OlegBEZb/Altium_CP/Altium_CP/Трёхмерный.png

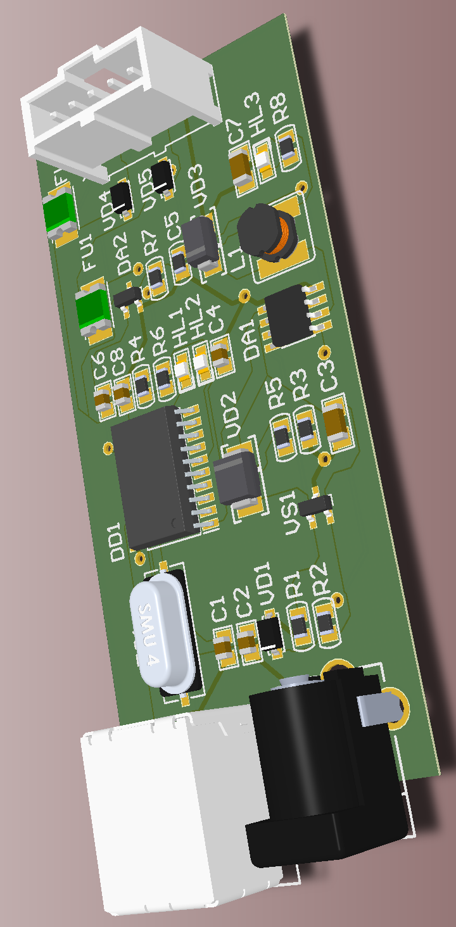
Altium_CP/Трёхмерный.png
