OlegBEZb/Altium_CP/README.md

Предмет: Программирование микроконтроллеров в робототехнике  
Преподаватель: Капустин Дмитрий Николаевич  
Семестр: 7
