OlegBEZb/Altium_CP/Altium_CP/Боттом.png

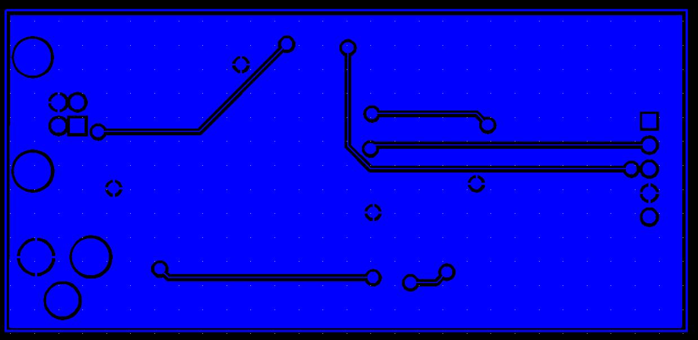
Altium_CP/Боттом.png
