OlegBEZb/Altium_CP/Altium_CP/Гербер все.png

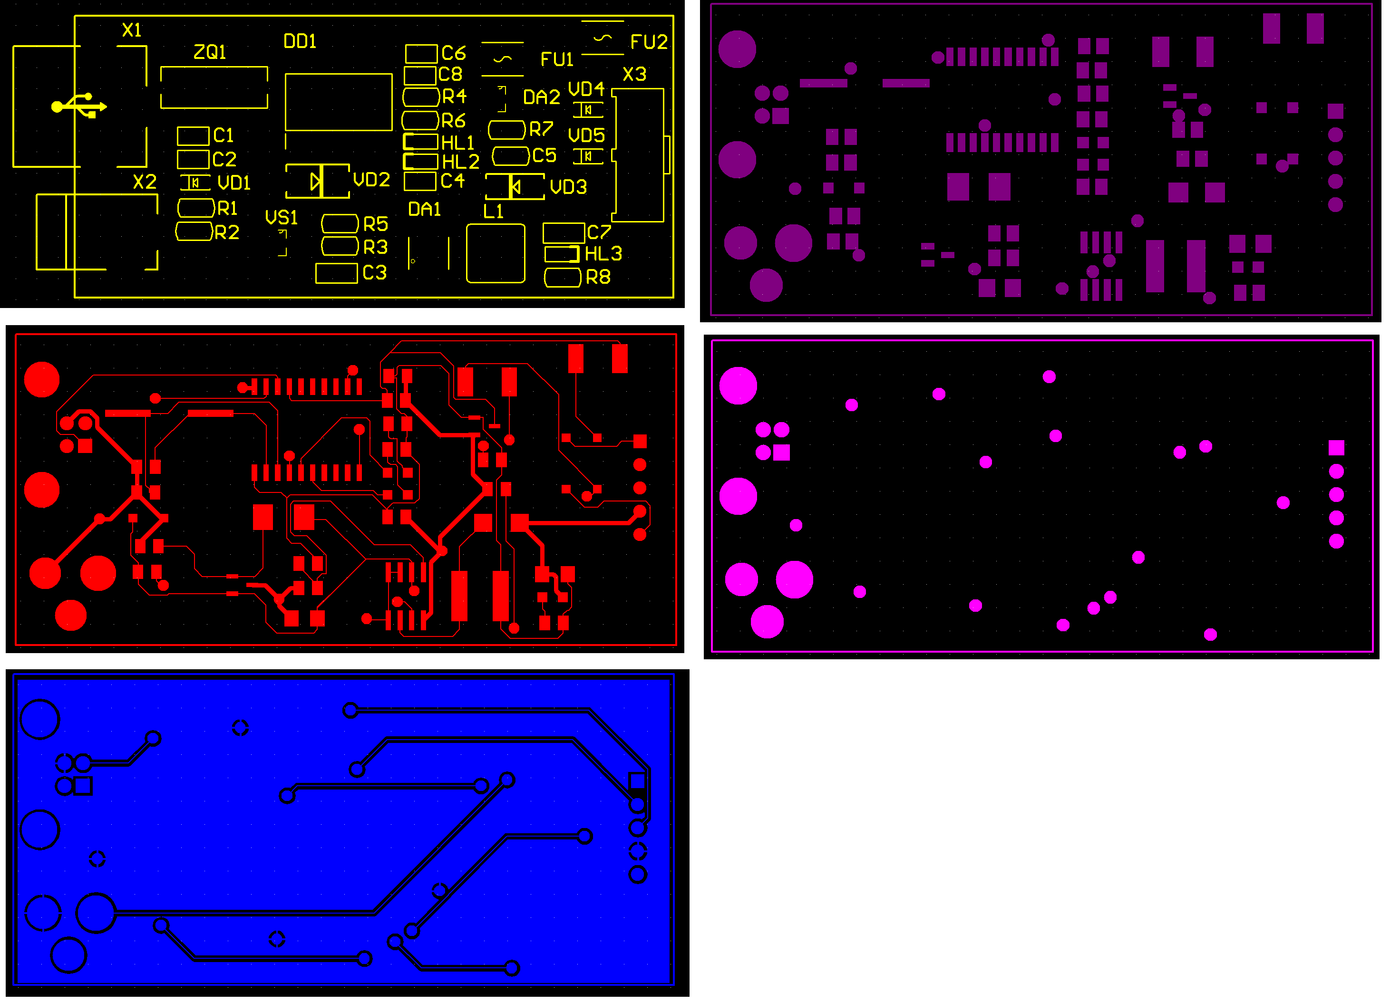
Altium_CP/Гербер все.png
