OlegBEZb/Altium_CP/Altium_CP/Гербер.png

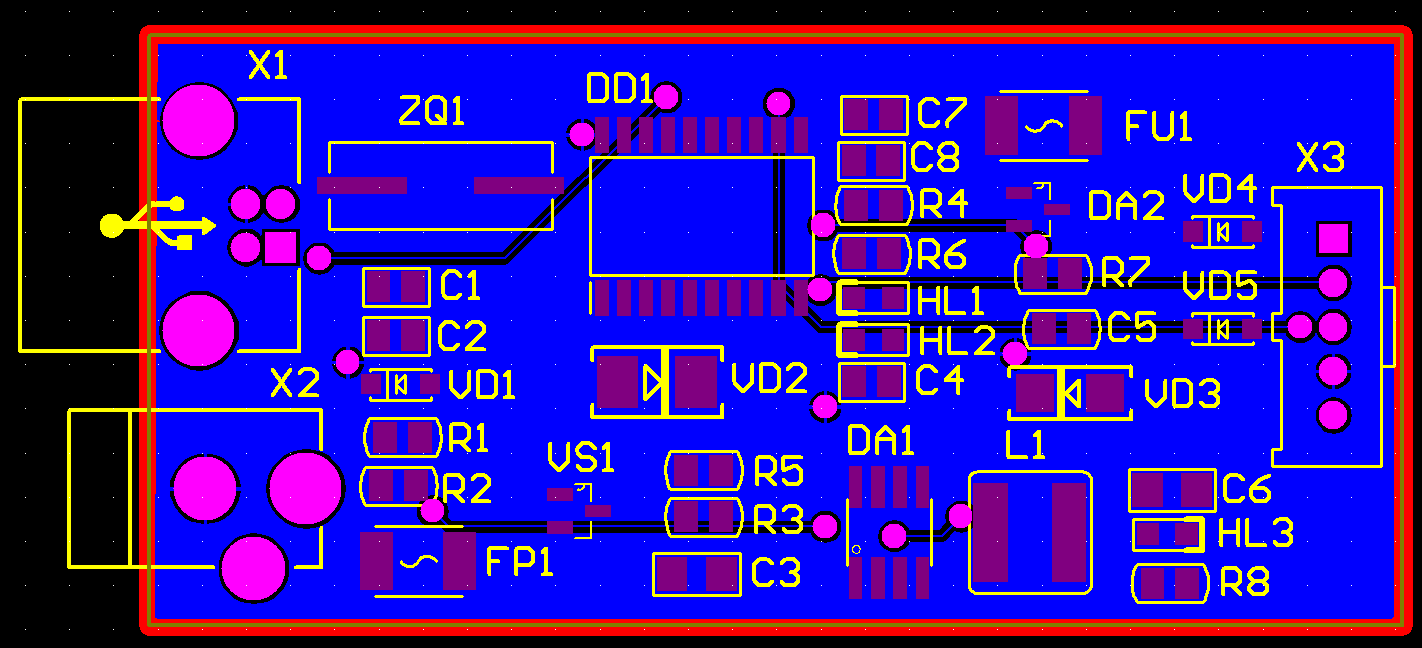
Altium_CP/Гербер.png
