OlegBEZb/Altium_CP/Altium_CP/Схема.png

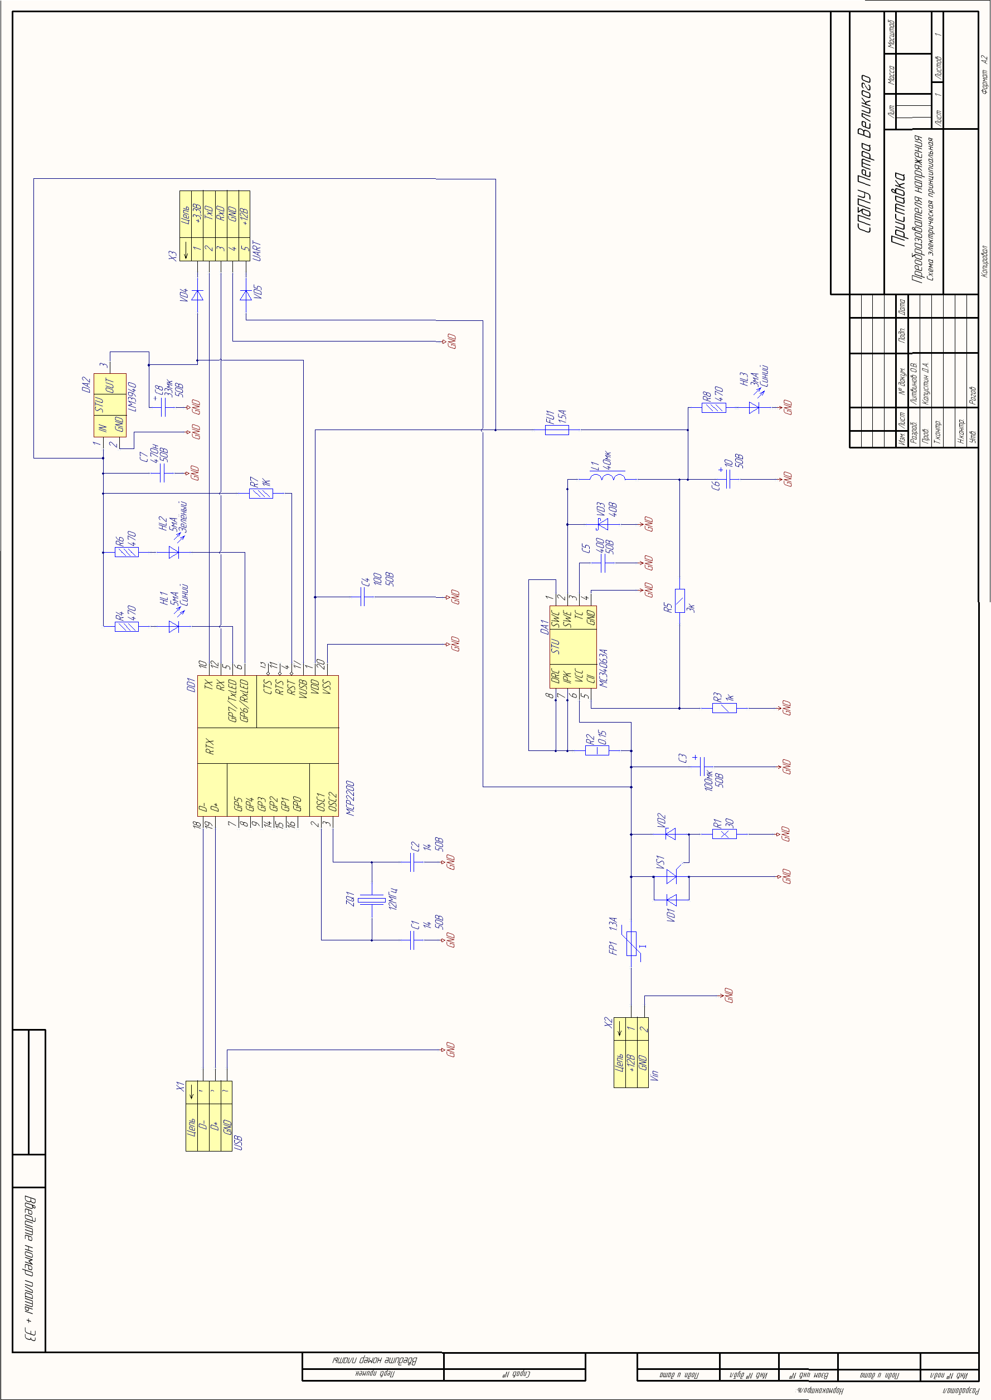
Altium_CP/Схема.png
