OlegBEZb/Altium_CP/Altium_CP/Топ оверлей.png

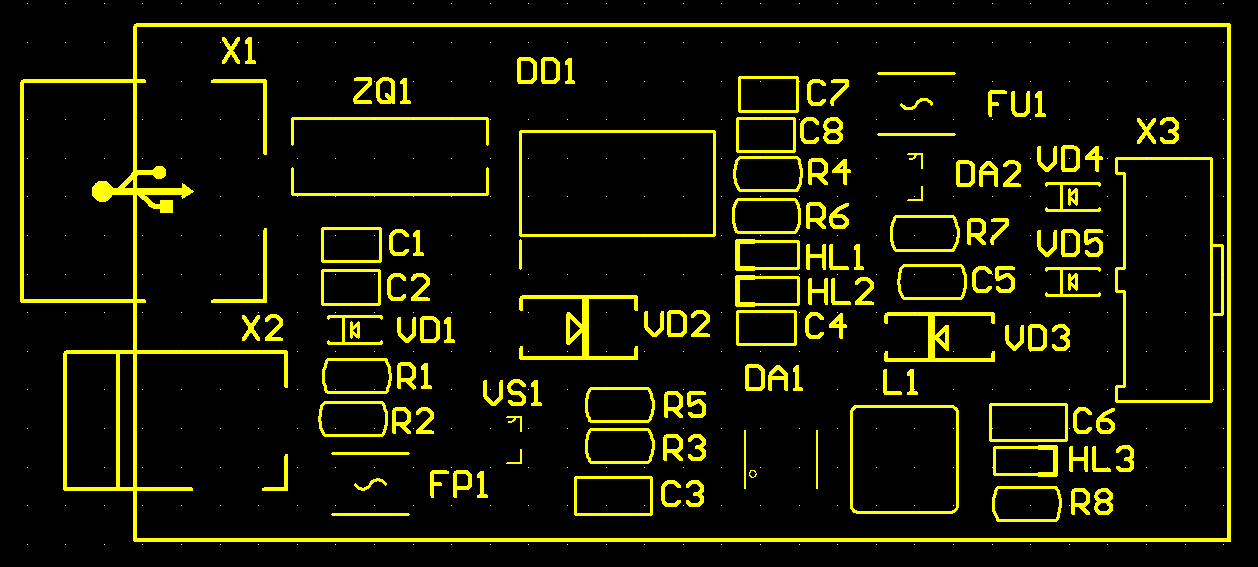
Altium_CP/Топ оверлей.png
