OlegBEZb/Altium_CP/Altium_CP/Топ солдер.png

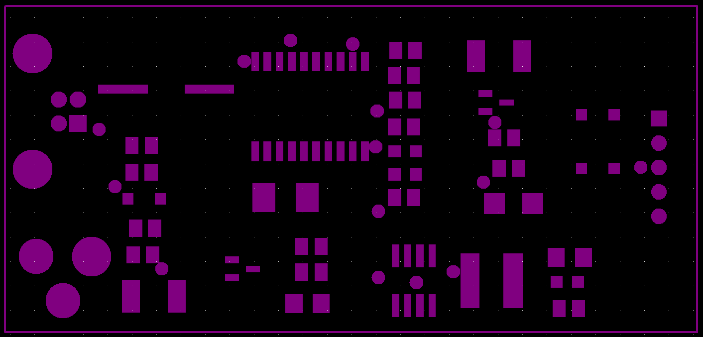
Altium_CP/Топ солдер.png
