OlegBEZb/Altium_CP/Altium_CP/Топ.png

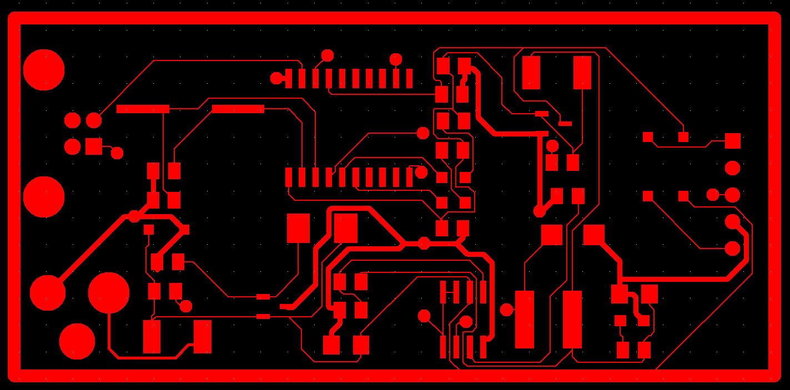
Altium_CP/Топ.png
