OlegBEZb/Altium_CP/Altium_CP/BOM.xlsx

№ | Описание | Наименование | Пр-ль | Корпус | Кол-во | Ст-ть |  | URL
 |  |  |  |  |  | 1 | 10
1 | Светодиод, 3.3 В, 0.5 А | KP-2012QBC-D | Kingbright Electronic | LD0805 | 3 | 17.04 ₽ | 170.40 ₽ | https://www.elitan.ru/price/item3451298
2 | Дроссель, 40 мкГ | 5240-RC | Bourns | МДГ-2 | 1 | 88.00 ₽ | 880.00 ₽ | https://www.elitan.ru/price/item780813
3 | Конденсатор, 100 мкФ, 50 В | EEE-FK1H101GP | Panasonic | C1206 | 1 | 66.02 ₽ | 660.20 ₽ | https://www.elitan.ru/price/item543783
4 | Конденсатор, 10 мкФ, 50 В | CL32B106KBJNNNE | Panasonic | C1206 | 1 | 11.20 ₽ | 112.00 ₽ | https://www.smd.ru/katalog/kondensatory/keramicheskie/cond1/cond2/cond3/
5 | Конденсатор, 239 мкФ, 50 В | GRM21BR71H154KA01L | Murata Manufacturing | R0805 | 1 | 1.55 ₽ | 15.50 ₽ | https://www.elitan.ru/price/item979509GRM21BR71H154KA01L
6 | Резистор, 0.125 Ом, 0.5 Вт | CR0805-J/-000E | Bourns | R0805 | 1 | 0.18 ₽ | 1.80 ₽ | https://www.elitan.ru/price/item979509
7 | Резистор, 180 Ом, 0.25 Вт | M.F.R. 1/4 W, 1%, 180 | KLS Electronic | R0805 | 1 | 6.52 ₽ | 65.20 ₽ | https://www.elitan.ru/price/item235543296
8 | Резистор, 1.5 кОм, 0.25 Вт | C.F.R. 1/4W 5% 1.5 К | KLS Electronic | R0805 | 1 | 0.16 ₽ | 1.60 ₽ | https://www.elitan.ru/price/item148320413
9 | Резистор, 13 кОм, 0.25 Вт | MFR-25JT-52-13K | Yageo | R0805 | 1 | 0.40 ₽ | 4.00 ₽ | https://www.elitan.ru/price/item10188308
10 | Резистор, 30 Ом, 10 Вт | ПЭВ-10-30-10% | АЛЗАС | R0805 | 2 | 195.00 ₽ | 1950.00 ₽ | https://www.elitan.ru/price/item422157
11 | Диод Шоттки, 40 В обр, 1 А прям | BYV10-40 | STMicroelectronics | DO-214AC | 1 | 25.90 ₽ | 259.00 ₽ | https://www.elitan.ru/price/item8375649
12 | Предохранитель плавкий, 100 мА, 5 В | 1812L150/12DR | LITTELFUSE | F1812 | 1 | 19.48 ₽ | 194.80 ₽ | https://ru.farnell.com/littelfuse/1812l150-12dr/fuse-ptc-resettable-12v-1-5a-1812/dp/2411298
13 | Микросхема | MC34063AC | STMicroelectronics | SO-8 | 1 | 14.55 ₽ | 145.50 ₽ | https://www.st.com/en/power-management/mc34063ac.html
14 | Стабилитрон, 12 В, 0.2 Вт | BZT52-С12S | PANJIT | SOD323 | 1 | 6.04 ₽ | 60.40 ₽ | https://www.smd.ru/katalog/poluprovodnikovye_diody_SMD/diody/stabilitrony/
15 | Коннектор-гнездо, USB type B | 670687041 | Molex | type B | 1 | 56.60 ₽ | 566.00 ₽ | https://www.elitan.ru/price/item775161
16 | Микросхема | MCP2200T-I/SS | Microchip Technology | SOIC | 1 | 213.00 ₽ | 2130.00 ₽ | https://www.elitan.ru/price/item238046174
17 | Резонатор, 12 МГц | AB-12.000MALE-T | TXC Corporation | HC-49SM | 1 | 59.52 ₽ | 595.20 ₽ | https://ru.mouser.com/ProductDetail/TXC-Corporation/AB-12000MALE-T?qs=m2I%2FBlFGQKMMPMBPhc0pZw%3D%3D
18 | Резистор, 470 Ом, 0.125 Вт | 0805S8J0471T5E | Royalohm/Royal Electronic Factory | R0805 | 2 | 0.44 ₽ | 4.40 ₽ | https://www.elitan.ru/price/item979509
19 | Резистор, 1 кОм, 0.125 Вт | RC0805JR-071KL | Yageo | R0805 | 1 | 1.00 ₽ | 10.00 ₽ | https://www.elitan.ru/price/item979509
20 | Коннектор-гнездо, UART | MOLEX 90136-1205 | MOLEX | 90136-1205 | 1 | 60.24 ₽ | 602.40 ₽ | https://www.tme.eu/ru/details/mx-90136-1205/razieemy-signalnye-rastr-254mm/molex/90136-1205/
21 | Самовосстанавливающийся предохранитель, 1.3 А, 12 В | RXEF065 | Littelfuse | PTC | 1 | 64.50 ₽ | 645.00 ₽ | https://www.elitan.ru/price/item71361
22 | Тиристор, 2 А, 100 В | 2N5062 | Central Semiconductor | TO-92 | 1 | 21.10 ₽ | 211.00 ₽ | https://www.elitan.ru/price/item75473
23 | Резистор, 1 Ом, 1 Вт | WSL2512R1500FEA | VISHAY | R0805 | 1 | 43.26 ₽ | 432.60 ₽ | https://ru.farnell.com/vishay/wsl2512r1500fea/current-sense-res-0r15-1-1-w-2512/dp/1107407RL
24 | Коннектор-гнездо, Power Jack | DCJ250-10-A-K1-K | GCT | Jack | 1 | 67.64 ₽ | 676.40 ₽ | https://ru.farnell.com/gct-global-connector-technology/dcj250-10-a-k1-k/dc-power-jack-5a-20vdc-black/dp/2524130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
 |  |  |  |  |  | 1039.34 ₽
