OlegBEZb/Altium_CP/Altium_CP/D0008A.stp

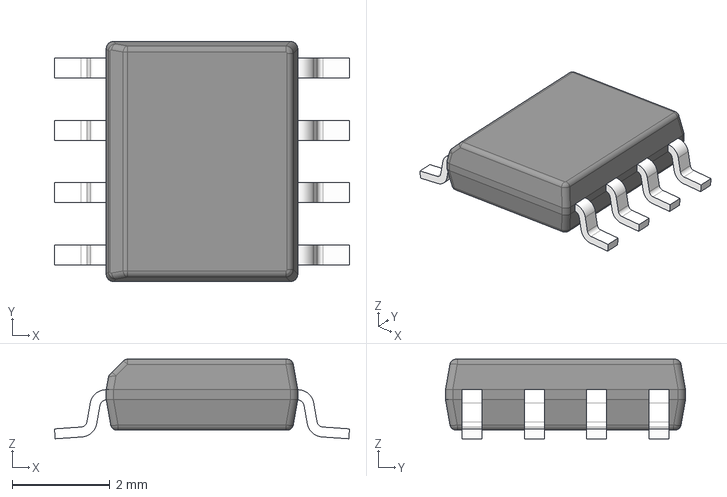
[picture p17: CAD file, 2018-12-30]
Altium_CP/D0008A.stp
6.02 x 4.90 x 1.63 mm
BODY-SO
LEAD-D0008A x 8
