OlegBEZb/Altium_CP/Altium_CP/MCP2200-I_SO.stp

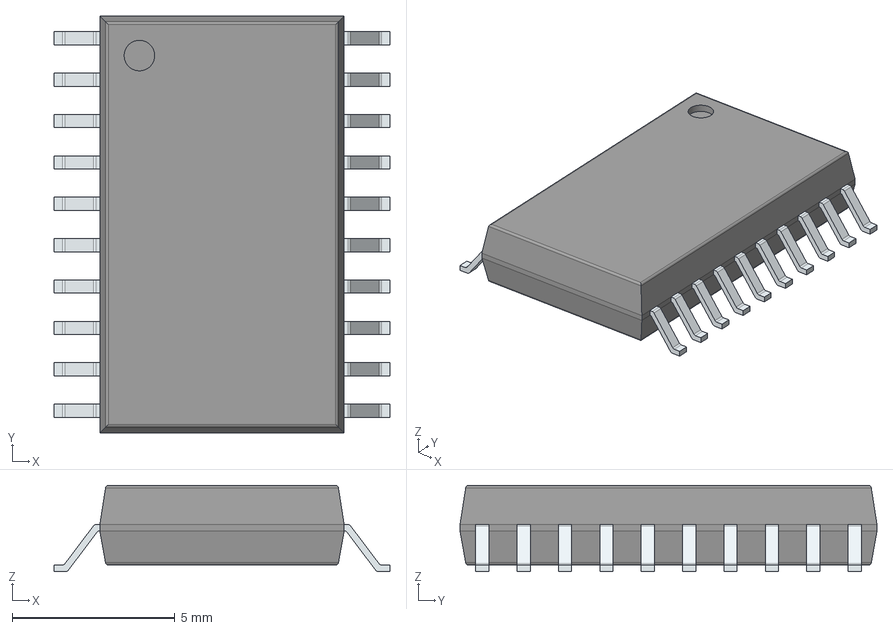
[picture p18: CAD file, 2018-12-30]
Altium_CP/MCP2200-I_SO.stp
10.3 x 12.8 x 2.65 mm
PinsArrayLR
