OlegBEZb/Altium_CP/Altium_CP/BSS138_D87Z--3DModel-STEP-56544.STEP

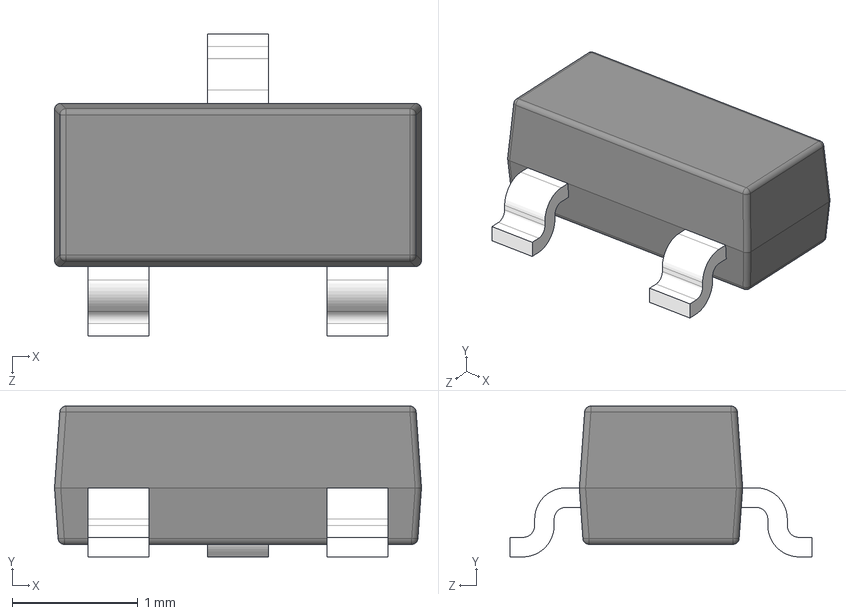
[picture p19: CAD file, 2018-12-30]
Altium_CP/BSS138_D87Z--3DModel-STEP-56544.STEP
2.92 x 1.20 x 2.40 mm
