OlegBEZb/Altium_CP/(list of files, drawings)

Other design files:
Altium_CP/A2.SchDoc
Altium_CP/CP_PCB.PcbDoc
Altium_CP/CP_Project.PrjPcb
Altium_CP/CP_Scheme.SchDoc
Altium_CP/Imported (1) MC34063A.lia/MC34063A.PcbLib
Altium_CP/Imported (1) MC34063A.lia/MC34063A.SchLib
Altium_CP/Imported LM3940.lia/LM3940.PcbLib
Altium_CP/Imported LM3940.lia/LM3940.SchLib
Altium_CP/Imported MC34063A.lia/MC34063A.PcbLib
Altium_CP/Imported MC34063A.lia/MC34063A.SchLib
Altium_CP/Imported REF3033AIDBZT.lia/REF3033AIDBZT.PcbLib
Altium_CP/Imported REF3033AIDBZT.lia/REF3033AIDBZT.SchLib
Altium_CP/Lab2_PCB.PcbDoc
Altium_CP/Lab2_Scheme.SchDoc
Altium_CP/MC34063A_pics.PcbLib
Altium_CP/MCP2200_UART_USB.schlib
Altium_CP/Pcb3d.PcbLib
