OlegBEZb/Altium_CP/(threads)

Thread 1 (2019-02-14):

Пожелание

KhomutovEvgeniy, 2019-02-14:
Доброй ночи, Олег!

Прошу вас добавить описание проекта в целях некоторой неспособности понять, можно ль найти здесь чтот интересное для себя. Буду признателен.
